rfar412/Part-4-Project-Compendium/README.md

# Part-4-Project-Compendium
Final research compendium to satisfy part 4 project requirements.
