rfar412/Part-4-Project-Compendium/submissions/Sunlink II Light based communication .pptx

## Project #48 Sunlink II: Light-Based Wireless Communication Using Sunlight

Presented by Ryan Farrell and Vivek Chauhan

## Research Question

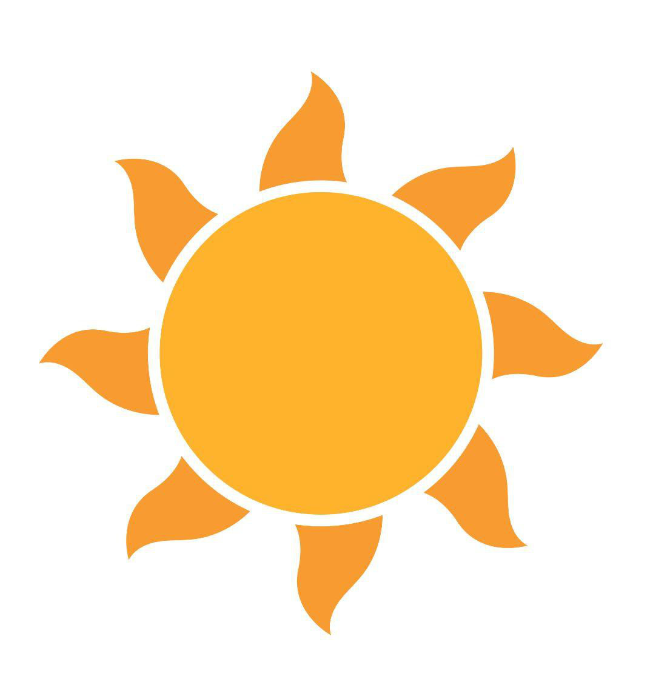
[picture p3: figure]

How can sun-tracking, light based communication systems be designed to provide reliable system-to-system data transmission using direct sunlight, while expanding on existing ambient light-based technologies?

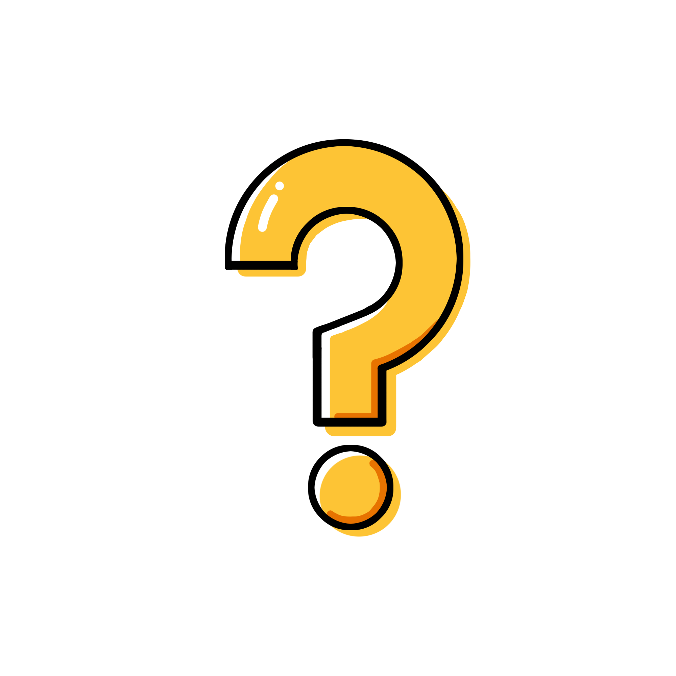
[picture p4: figure]

## Project Introduction

What is Sunlink II ?
- A passive, sunlight-based wireless communication system.
Motivation:
- Avoid RF congestion, enabling low-power, remote sensing data links
- Reliable VLC through Sun tracking and multi-node communication

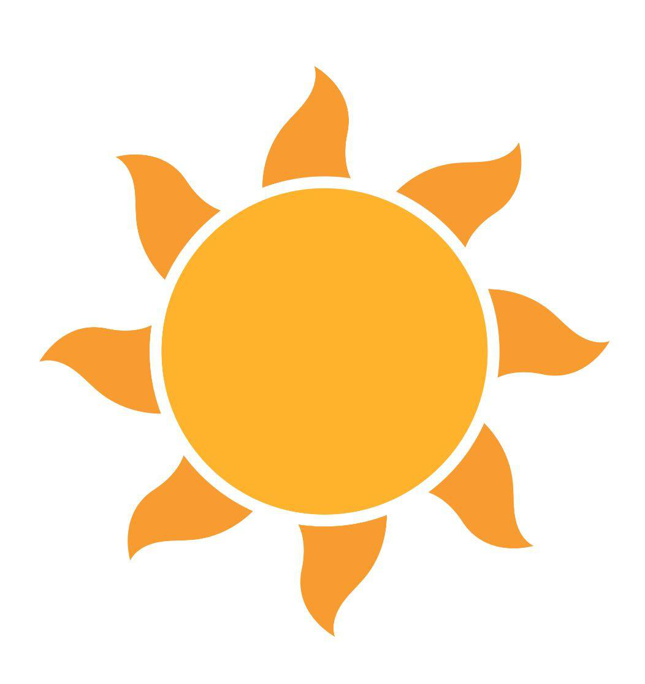
[picture p5: figure]
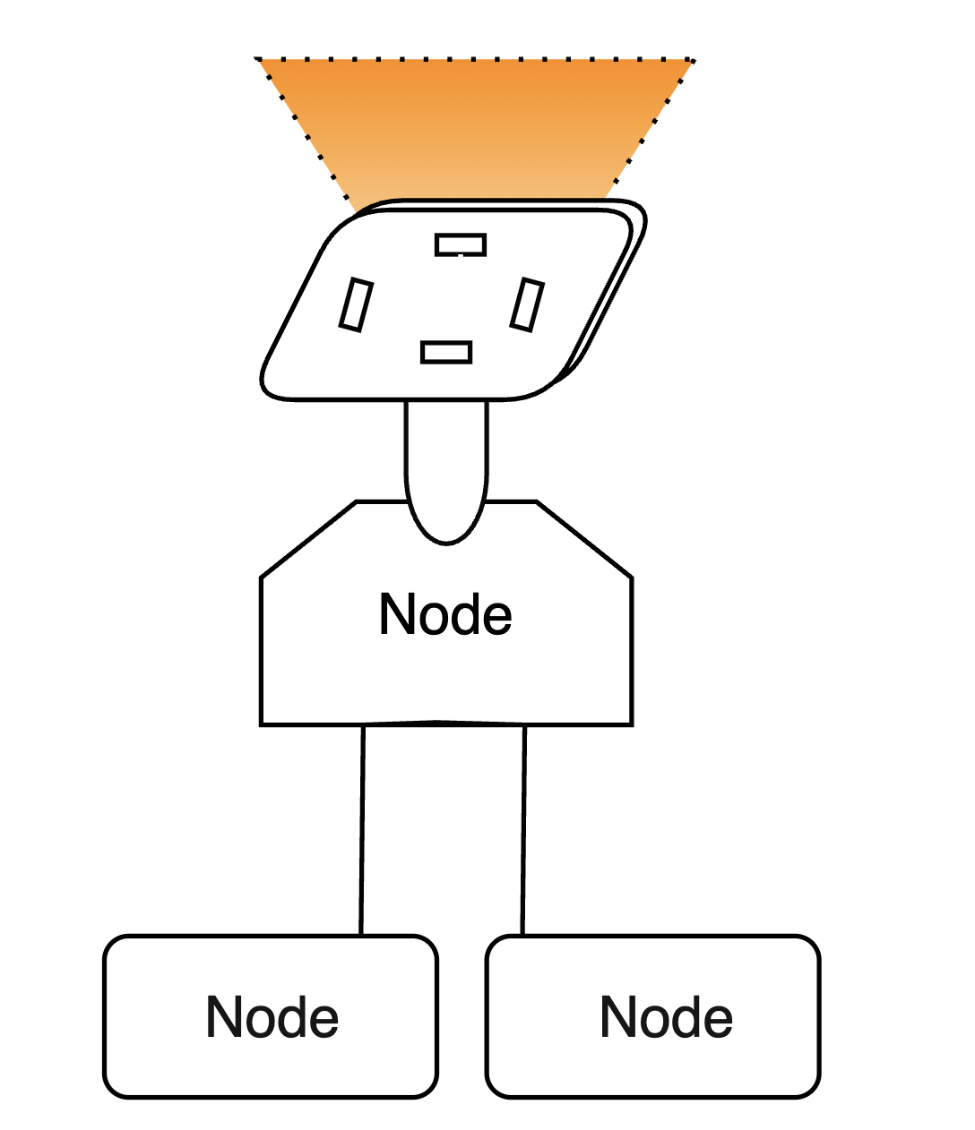
[picture p6: figure]

## System Architecture Overview

Sunlink II

Sun Tracking Subsystem

Multi-Nodal Subsystem

## Sun- Tracking Subsystem

## Sun tracking Problem & Requirements

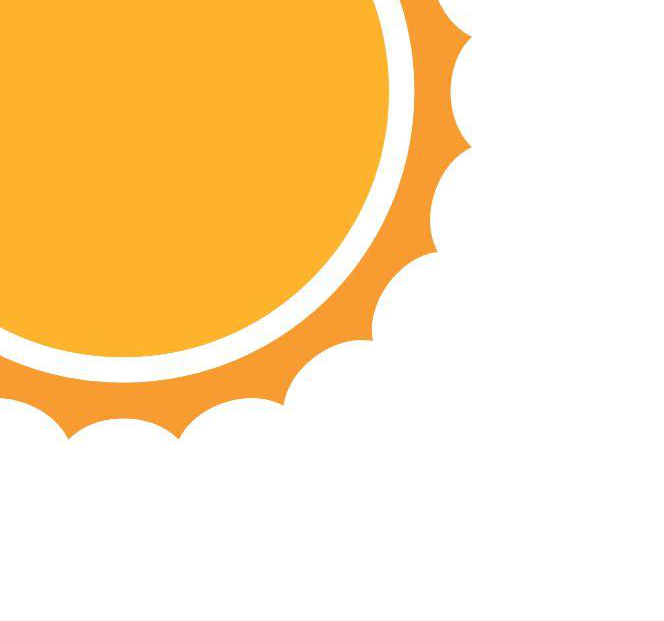
[picture p7: figure]

Why is tracking is needed:
- Sun light azimuth/elevation changes over time.
- Maximising Optical Alignment Improving signal strength
Tracking range required:
- Azimuth: ~180°
- Elevation: ~0-90°

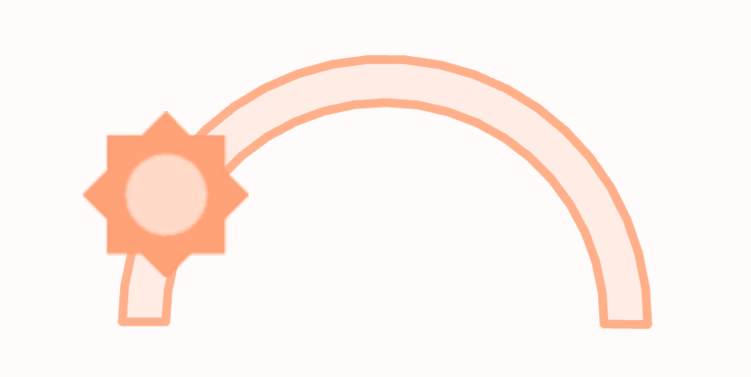
[picture p8: figure]

## Mechanical System Design

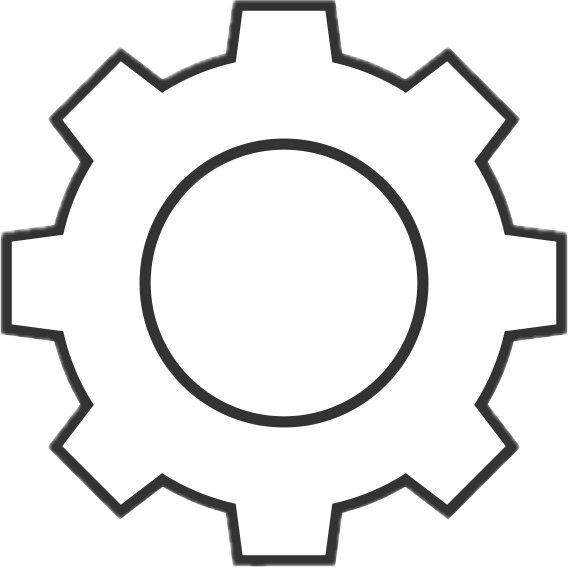
[picture p9: figure]

Dual- axis pan-tilt platform
- Stepper Motor + Driver for Azimuth & Elevation
- Why a Stepper and Servo set-up?
Use of 3D printing for Mock Design, and frame to allow for modular component placement.

## Sensor & Sun Detection

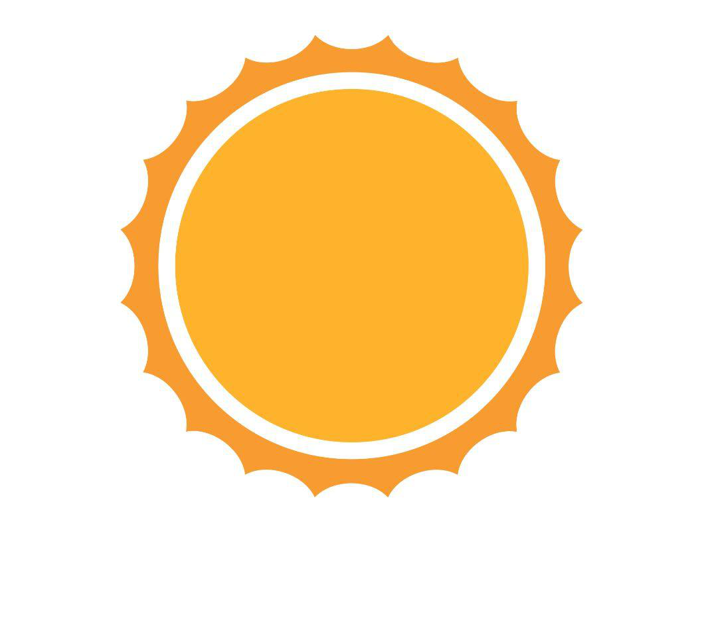
[picture p10: figure]

Sensor Array:
- Hybrid Light Light Dependent Resistor (LDR) + Photodiode Design
Directional Error Logic:
- Quadrant sensor layout for azimuth/ elevation correction
Liquid Crystal (LC) shutter modulator placed along light axis

## Control System Design (PID)

Proportional–Integral–Derivative controller:
Input : Light Imbalance Error

Output : Stepper motor commands ( Step logic )
Microcontroller : MSP-430

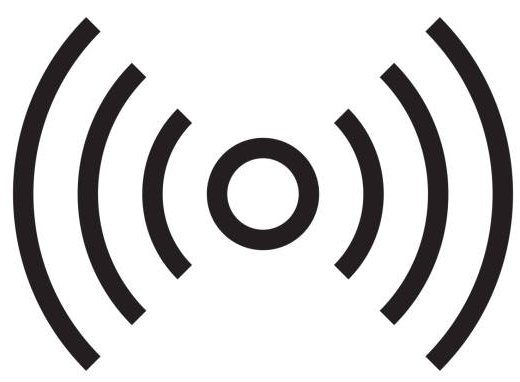
[picture p11: figure]
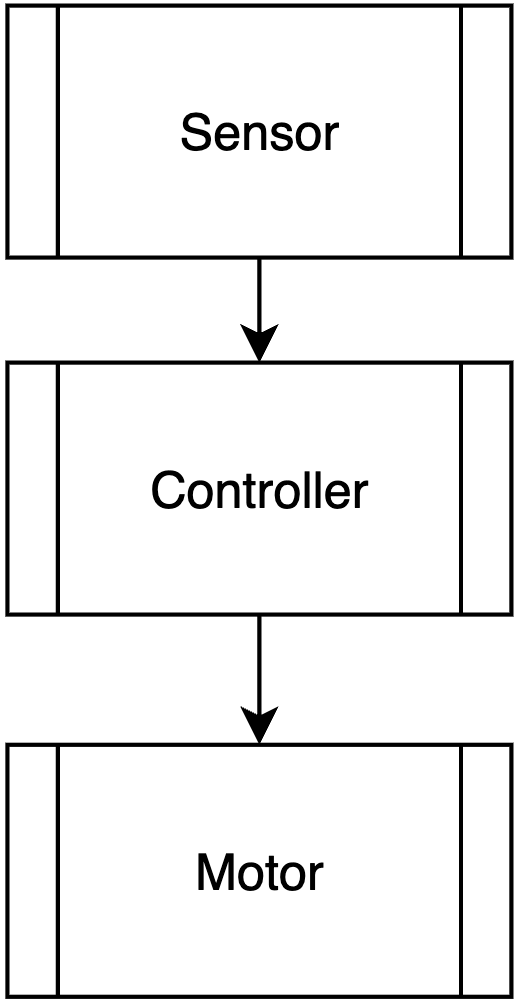
[picture p12: figure]
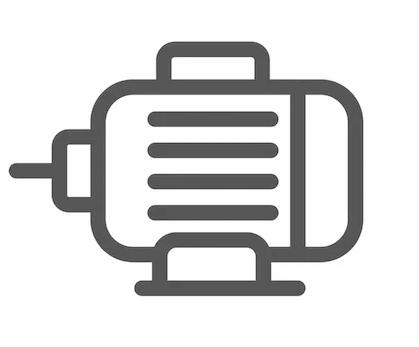
[picture p13: figure]

## Visible Light Communication

## Ambient Light Backscattering

- What is Ambient Light Backscattering (ALB)?
  - The idea of embedding data into existing ambient light
- Why not Radio Frequency (RF)?
  - Passive transmission source -> Low power
  - No powerful transmitter required -> Cheaper
  - RF spectrum -> Clustered

Notes: Talk about low power requirements because no active source (leveraging existing source)

## Ambient Light Backscattering

- How are we utilising this technology?

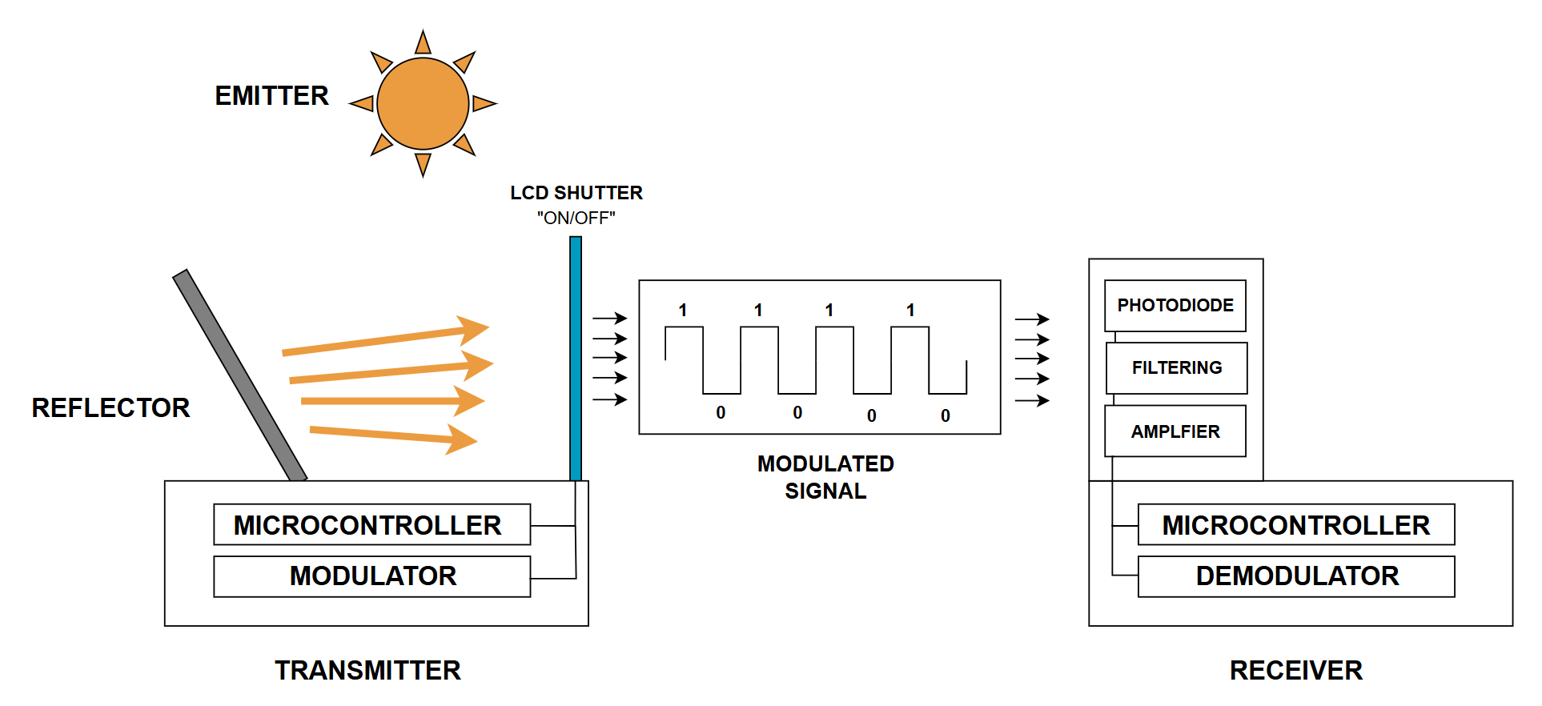
[picture p14: figure]
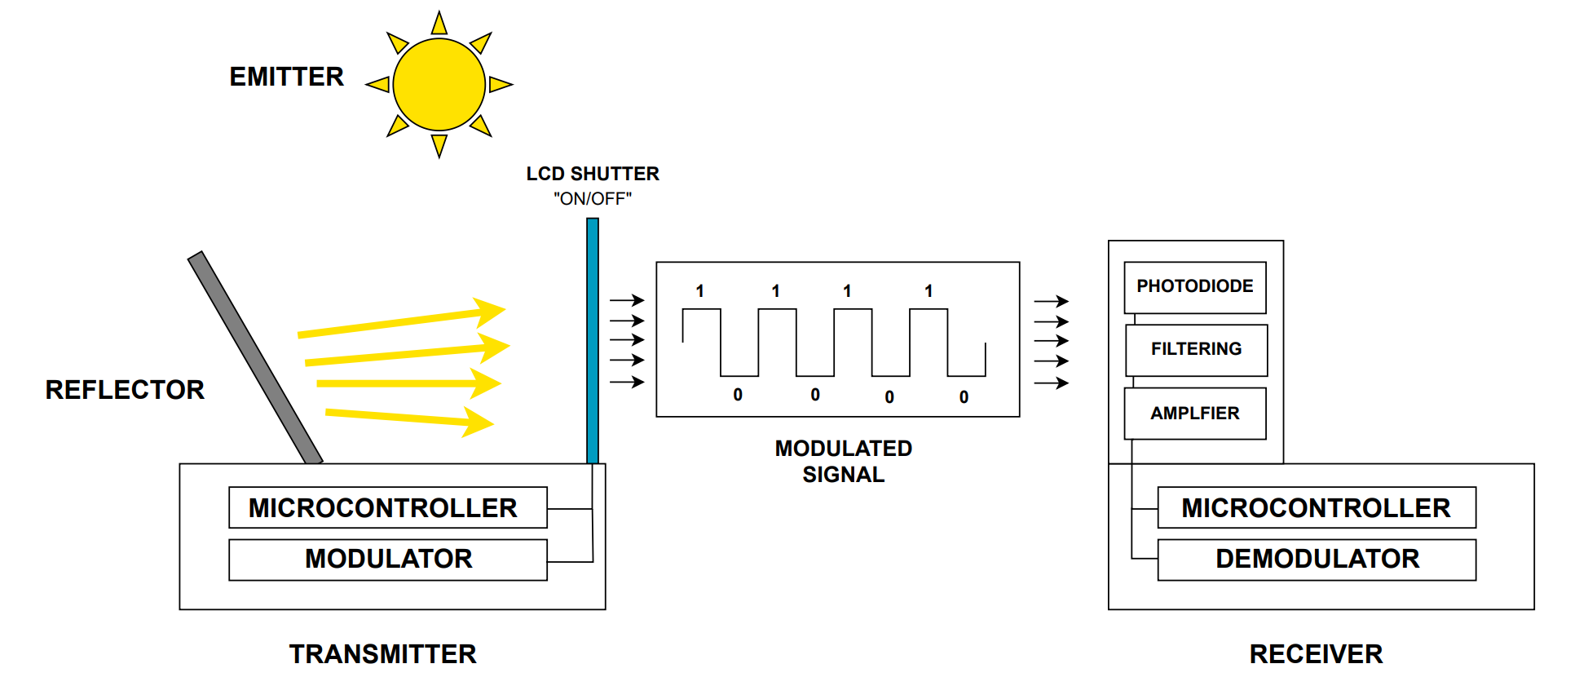
[picture p15: figure]

Notes: Talk about low power requirements because no active source (leveraging existing source)

## User Access and Interface

- Each node has a Bluetooth module for local access
- Users can connect to download the most recent message
- This allows decentralised, resilient access - even if some nodes fail

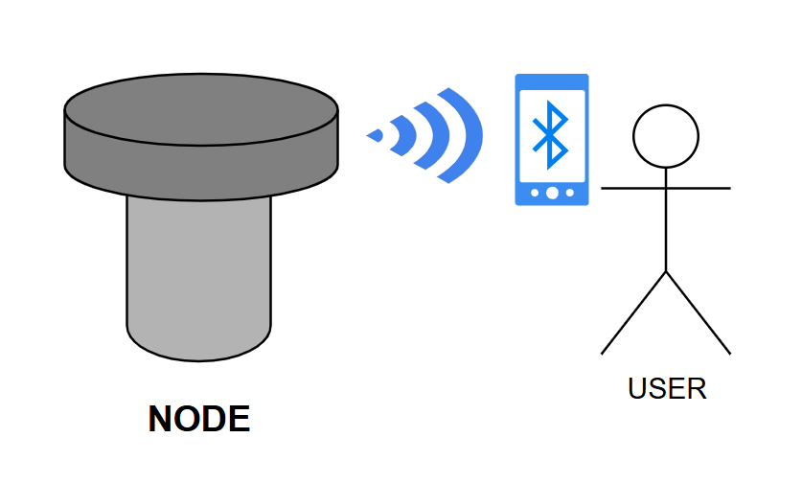
[picture p16: figure]

## Multi-Nodal Communication

- What is a multi-nodal communication system?

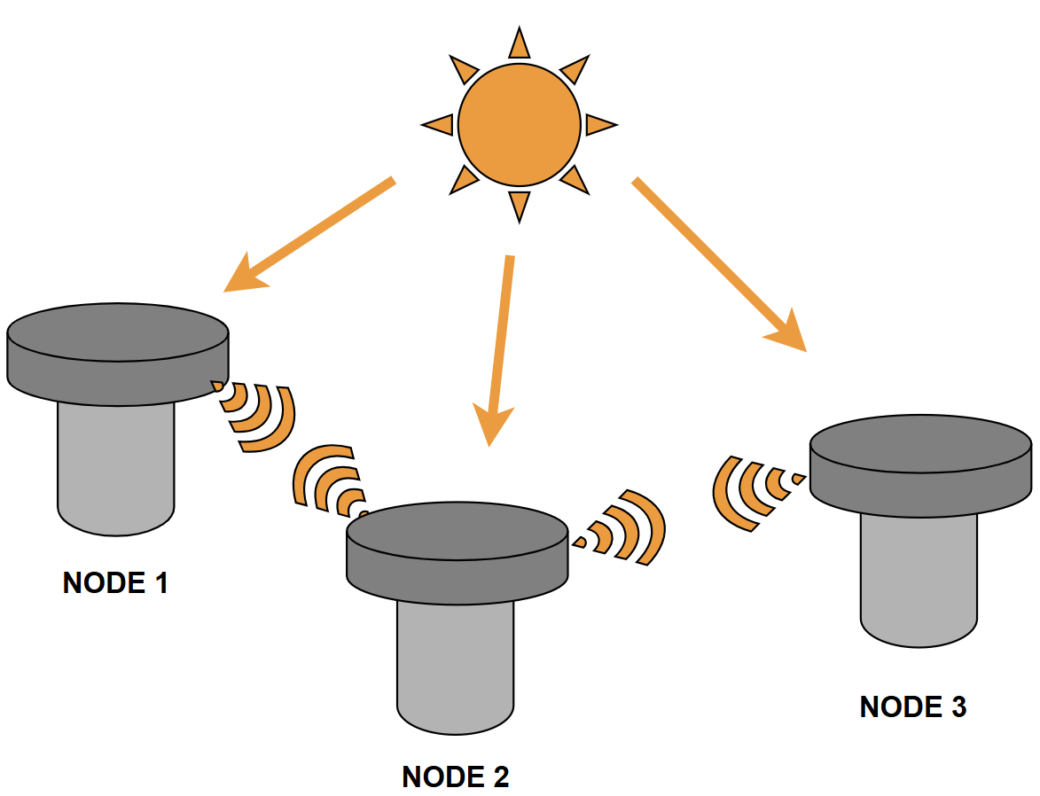
[picture p17: figure]
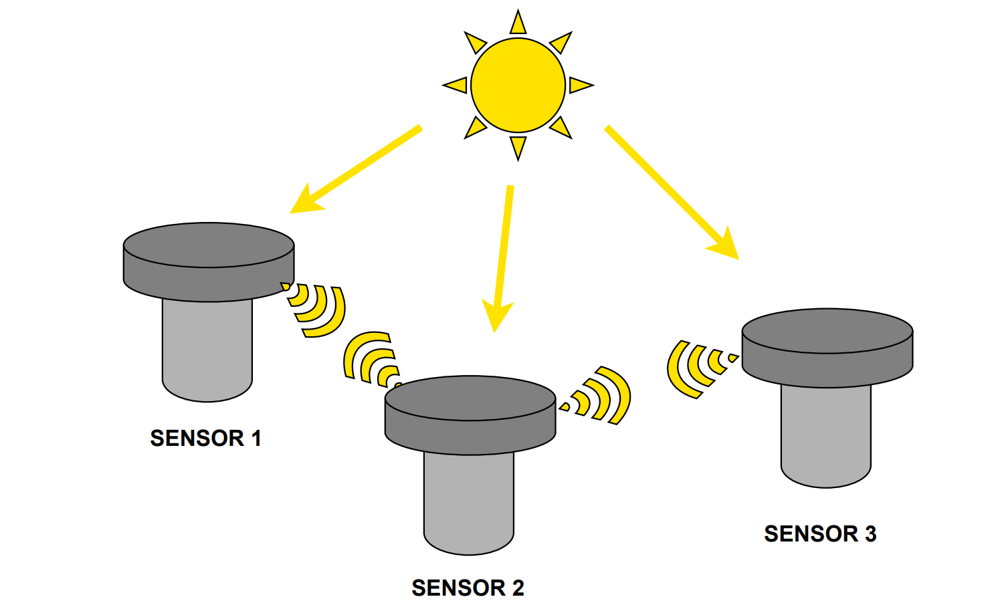
[picture p18: figure]

## Multi-Nodal Communication

- Motivation for multi-nodal system?
- Any similar or existing platforms in research field?

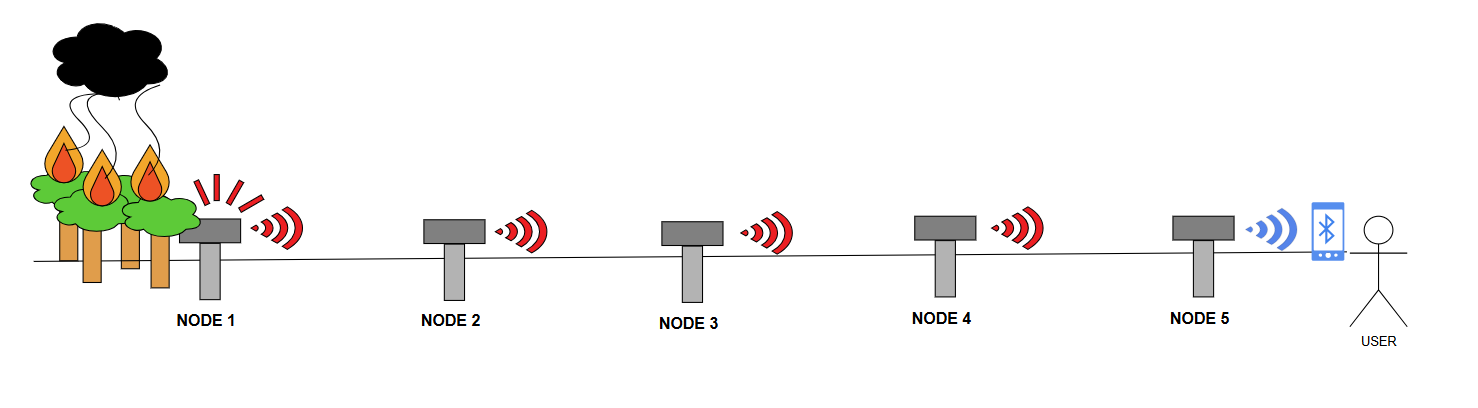
[picture p19: figure]

## Expected Challenges

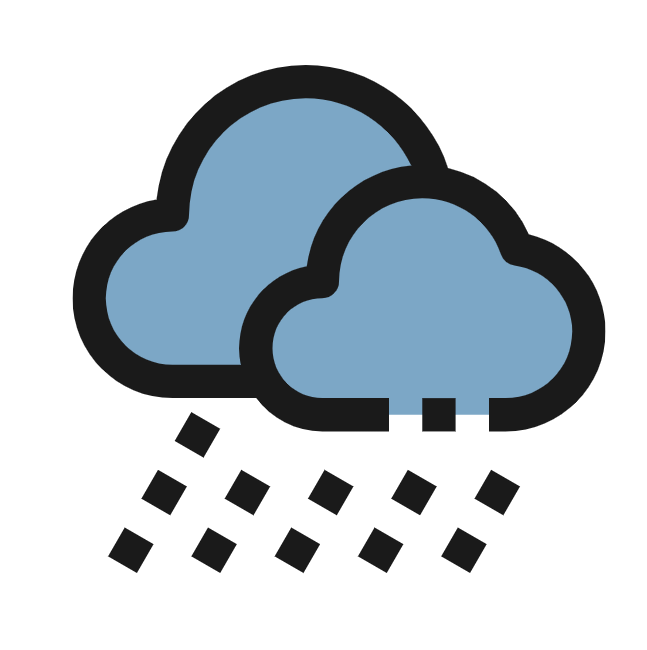
[picture p20: figure]

Challenges
- Sensor alignment for light paths
- Ambient noise
- Weather dependence

## System Integration & Evaluation Strategies

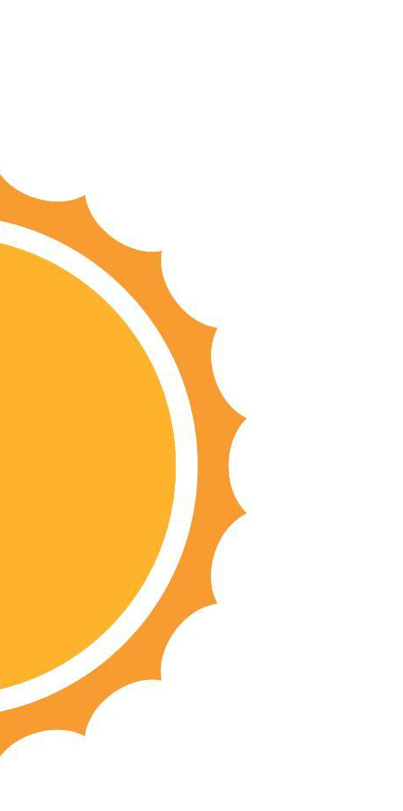
[picture p21: figure]

Sun- Tracking Subsystem | Communication Subsystem
Accuracy | Range
Responsiveness | Message Accuracy
Angular Deviation | Variable Lighting

## System Integration & Evaluation Strategies

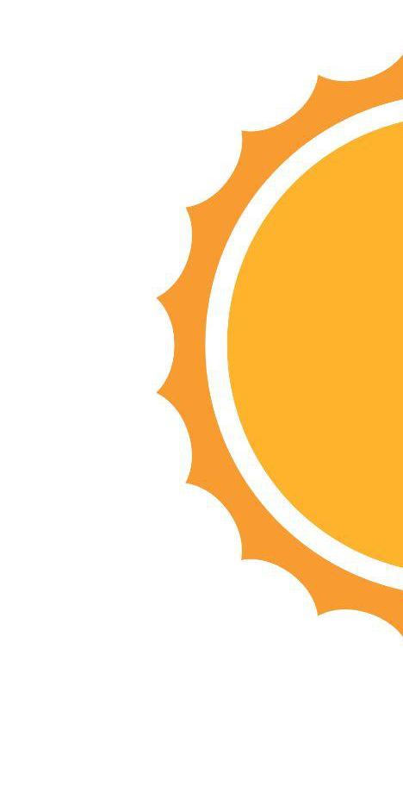
[picture p22: figure]

FULL SYSTEM INTEGRATION
Power consumption
Range
Reliability under different lighting conditions

## Conclusion

Bringing it All Together: A Low-Power, Light-Based Sensing Network

- Low Power - For remote sensing applications
- Sun Tracking - For maximised light signal strength
- Multi-Node - Allows for a signal chain
- Local Access - Decentralised, resilient access

## Thank you for your attention!

- Q&A

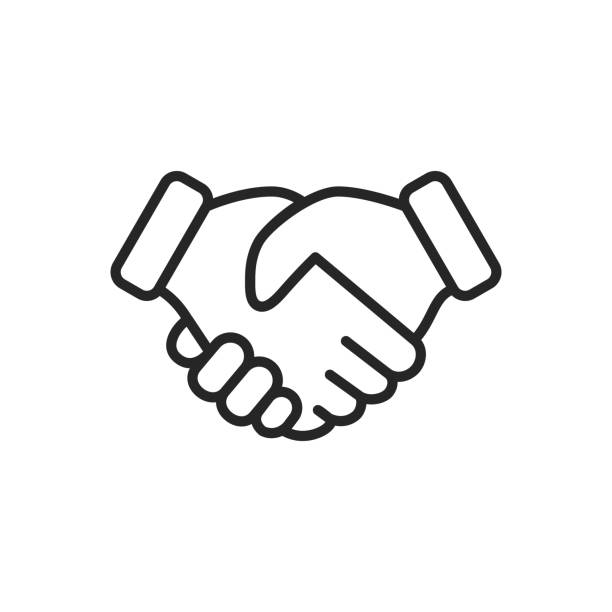
[picture p23: figure]
