rfar412/Part-4-Project-Compendium/project_details/tracking_subsystem_docs/Process Diagram.png

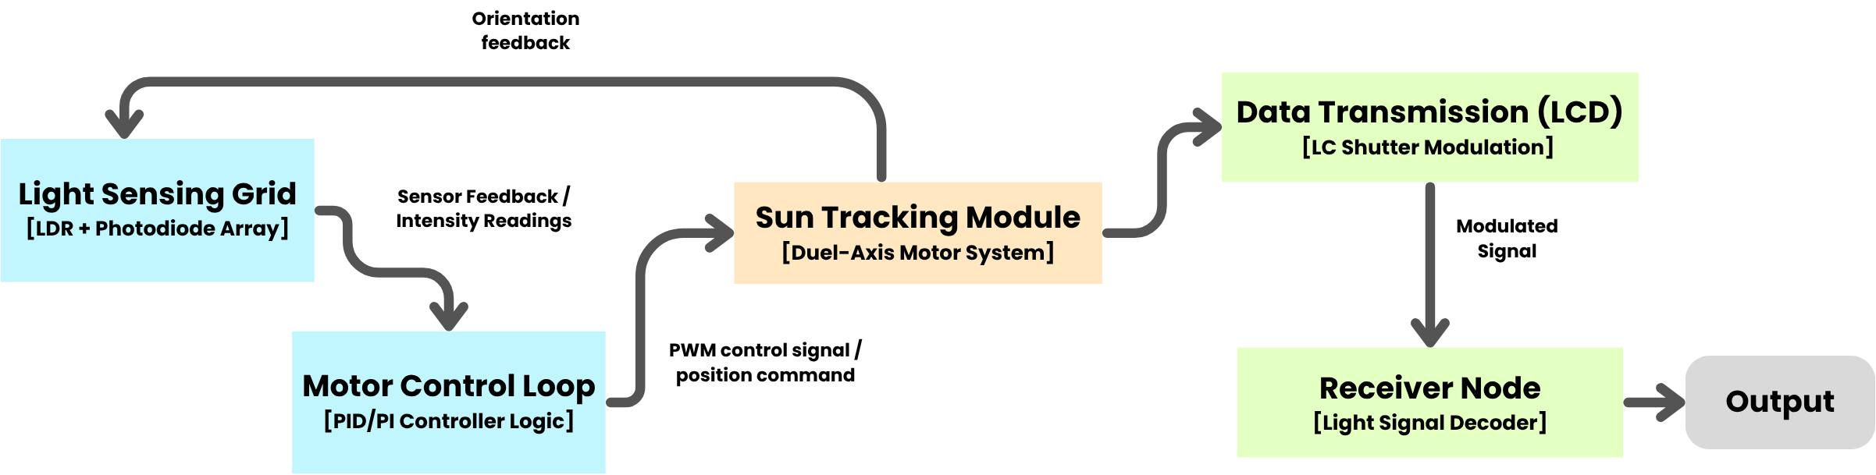
project_details/tracking_subsystem_docs/Process Diagram.png
