rfar412/Part-4-Project-Compendium/project_details/tracking_subsystem_docs/tracking_control_flow.png

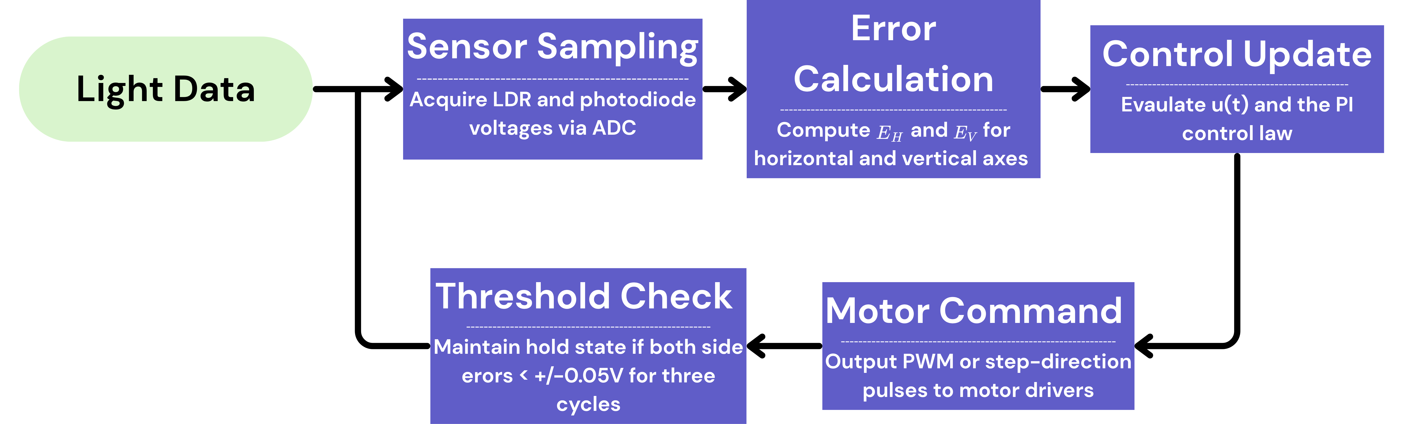
project_details/tracking_subsystem_docs/tracking_control_flow.png
