rfar412/Part-4-Project-Compendium/schematic_parts/communication_subsystem/mosfet_driver.png

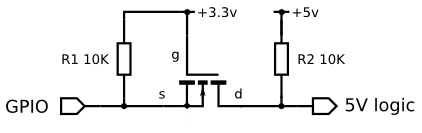
schematic_parts/communication_subsystem/mosfet_driver.png
