rfar412/Part-4-Project-Compendium/schematic_parts/communication_subsystem/receiver_circuitry.png

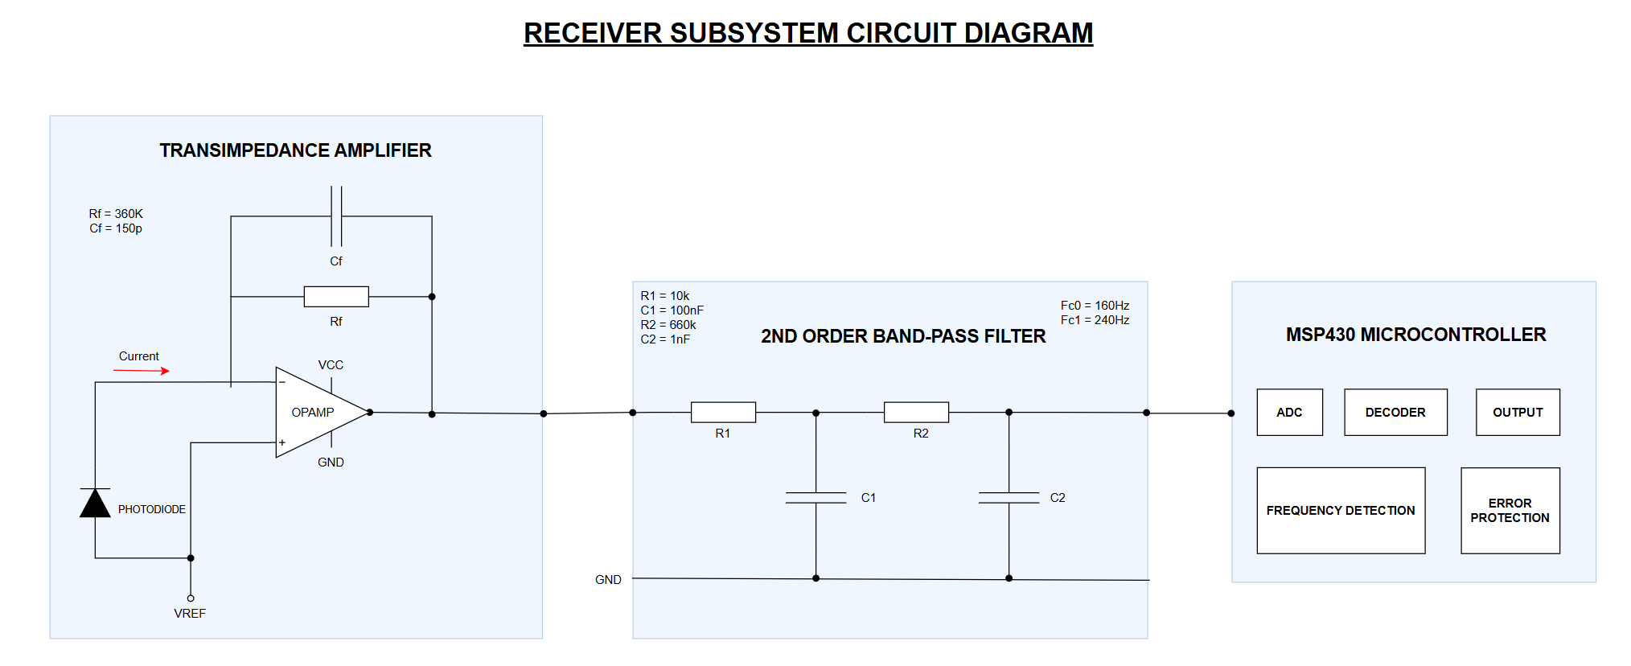
schematic_parts/communication_subsystem/receiver_circuitry.png
