rfar412/Part-4-Project-Compendium/project_details/communication_subsystem_docs/testing_setup.jpg

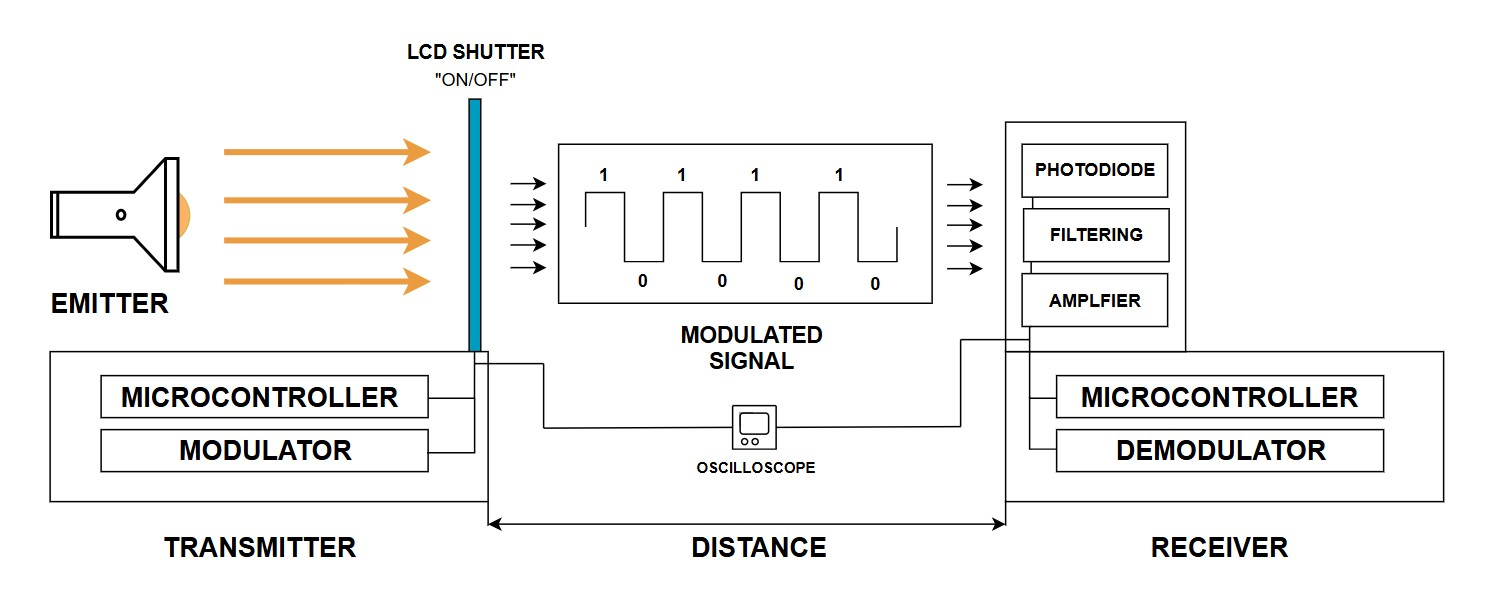
project_details/communication_subsystem_docs/testing_setup.jpg
