rfar412/Part-4-Project-Compendium/results/tracking_subsystem/Motor_Test_Data.xlsx

Parameter | Measured | Simulated
Supply Voltage | 11.76 V | 11.90 V
Coil Voltage Drop | 3.357 V / phase | 3.88 V / phase
Supply Current | 1.325 A | 1.30 A
Motor Back-EMF | 0.789 V | 0.81 V
PWM Switching Frequency | 19.87 kHz | 20.2 kHz
Idle Voltage (no step) | 0.015 V | 0.02 V
Full-Step Voltage (single) | 0.267 V | 0.356 V | Trails | Test One | Test Two | Test Three | Choose Highest Values
Step (0–90°) | 1.265 V | 1.147 V |  | 1.265 V | 1.211 V | 1.235 V
Step (0–180°) | 4.543 V | 4.565 V |  | 4.541 V | 4.5209 V | 4.543 V
Step (0–270°) | 10.087 V | 10.42 V |  | 10.087 V | 10.012 V | 10.036 V
Step (0–90°) | 0.814 A | 0.821 A |  | 0.809 A | 0.799 A | 0.814 A
Step (0–180°) | 0.958 A | 0.965 A |  | 0.951 A | 0.958 A | 0.946 A
Step (0–270°) | 1.224 A | 1.289 A |  | 1.213 A | 1.217 A | 1.289 A
