rfar412/Part-4-Project-Compendium/results/tracking_subsystem/Light Sensor Data.xlsx

Brightness_% | Sensor_Angle_deg | Torch_Angle_deg | Angular_Offset_deg | Aligned_Lux_at_Brightness | Incident_Lux_PD | Incident_Lux_LDR | PD_Voltage_V | LDR_Voltage_V
10 | 0 | 135 | 135 | 200 | 9.56 | 20.03 | 0.4778 | 2.8797
10 | 60 | 135 | 75 | 200 | 58.54 | 69.19 | 2.9269 | 3.8194
10 | 120 | 135 | 15 | 200 | 184.07 | 201.91 | 4.41241 | 4.3628
10 | 180 | 135 | 45 | 200 | 142.16 | 153.79 | 4.05635 | 4.2491
10 | 240 | 135 | 105 | 200 | 10.14 | 20.29 | 1.107 | 2.891
10 | 270 | 135 | 135 | 200 | 9.96 | 20.66 | 0.498 | 2.9063
Brightness_% | Sensor_Angle_deg | Torch_Angle_deg | Angular_Offset_deg | Aligned_Lux_at_Brightness | Incident_Lux_PD | Incident_Lux_LDR | PD_Voltage_V | LDR_Voltage_V
50 | 0 | 135 | 135 | 1000 | 50.52 | 103 | 2.526 | 4.0519
50 | 60 | 135 | 75 | 1000 | 286.1 | 359.45 | 5 | 4.5556
50 | 120 | 135 | 15 | 1000 | 954.52 | 1115.09 | 5 | 4.7885
50 | 180 | 135 | 45 | 1000 | 712.16 | 806.55 | 5 | 4.7375
50 | 240 | 135 | 105 | 1000 | 48.32 | 98 | 2.4159 | 4.0249
50 | 270 | 135 | 135 | 1000 | 48.57 | 100.96 | 2.4284 | 4.0412
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
