rfar412/Part-4-Project-Compendium/project_details/tracking_subsystem_docs/Tracking_sub_testing.png

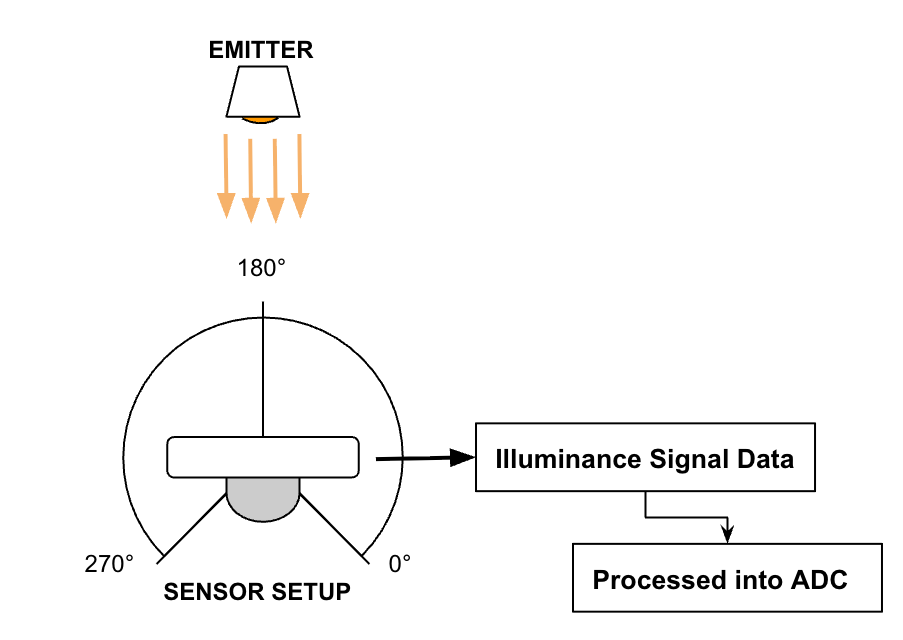
project_details/tracking_subsystem_docs/Tracking_sub_testing.png
