rfar412/Part-4-Project-Compendium/results/communication_subsystem/20cm.png

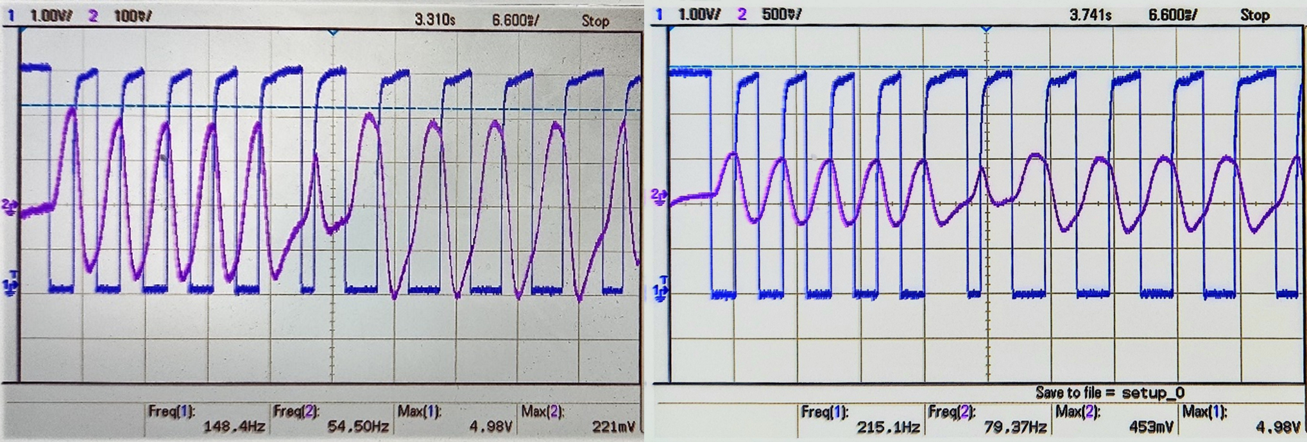
results/communication_subsystem/20cm.png
