rfar412/Part-4-Project-Compendium/results/communication_subsystem/50cm.png

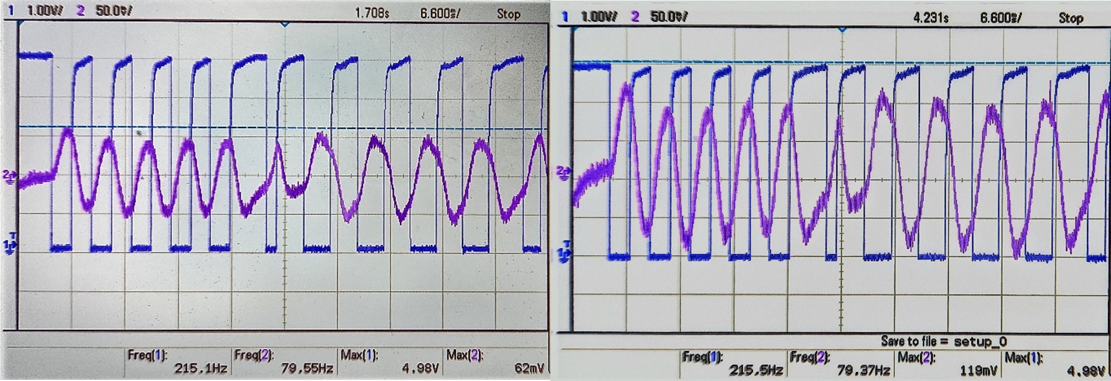
results/communication_subsystem/50cm.png
