rfar412/Part-4-Project-Compendium/results/communication_subsystem/100cm.png

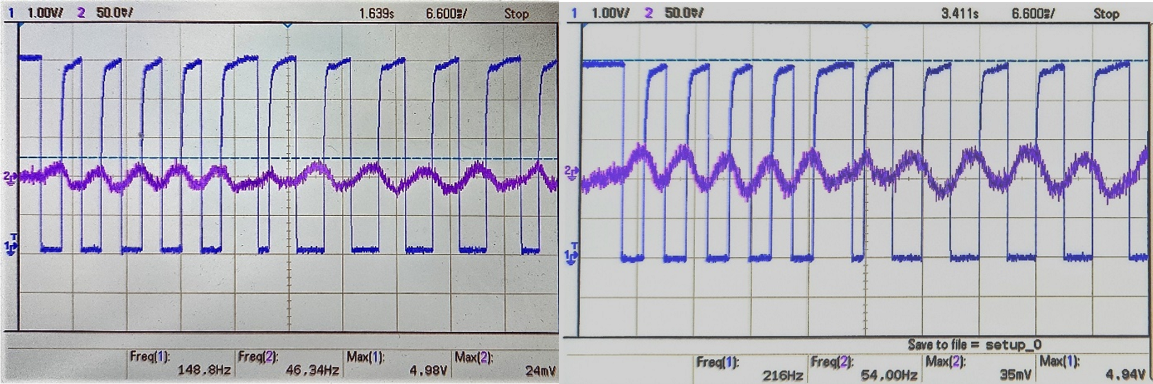
results/communication_subsystem/100cm.png
