rfar412/Part-4-Project-Compendium/results/communication_subsystem/CamScanner 16-10-2025 18.06_5.jpg

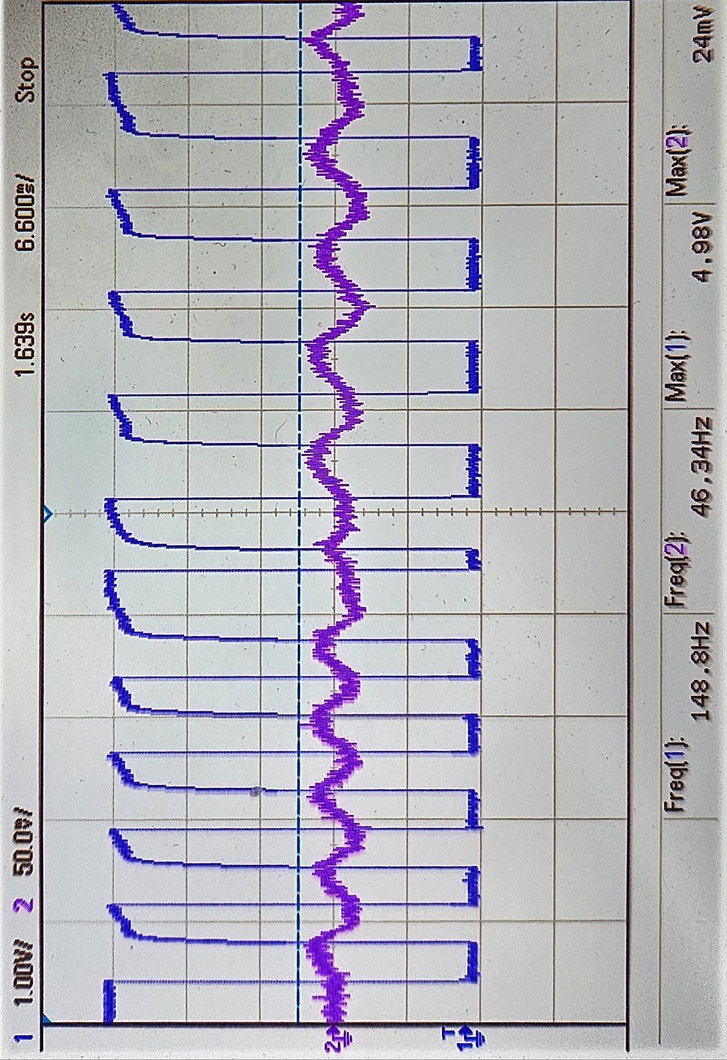
results/communication_subsystem/CamScanner 16-10-2025 18.06_5.jpg
