rfar412/Part-4-Project-Compendium/results/communication_subsystem/graph_communication.png

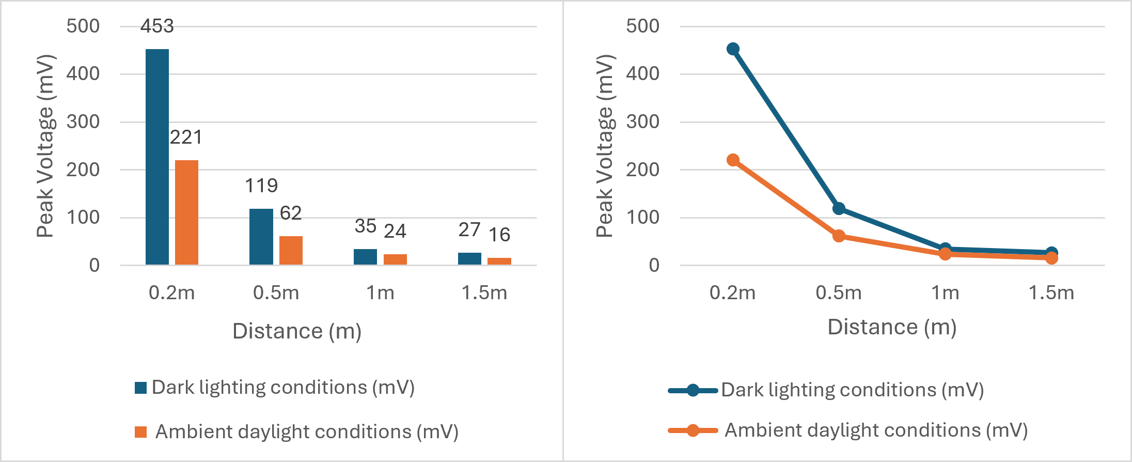
results/communication_subsystem/graph_communication.png
