rfar412/Part-4-Project-Compendium/results/communication_subsystem/noise.png

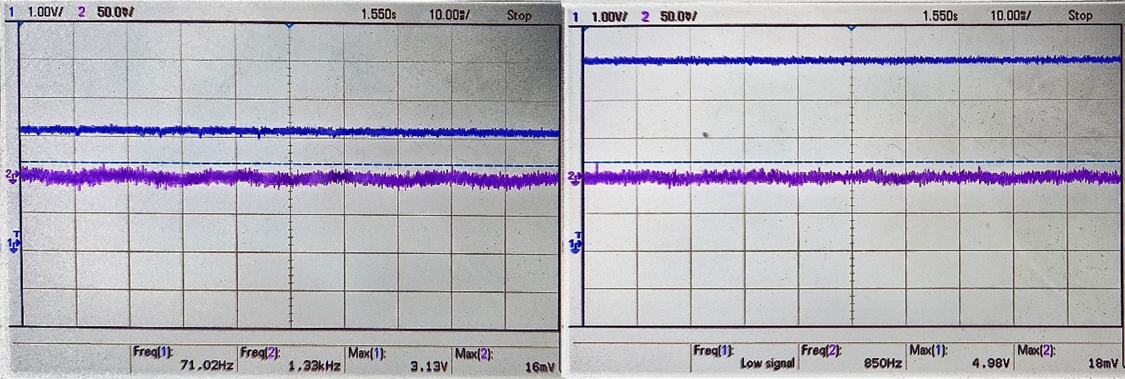
results/communication_subsystem/noise.png
