rfar412/Part-4-Project-Compendium/results/tracking_subsystem/incident_lux_vs_angle.png

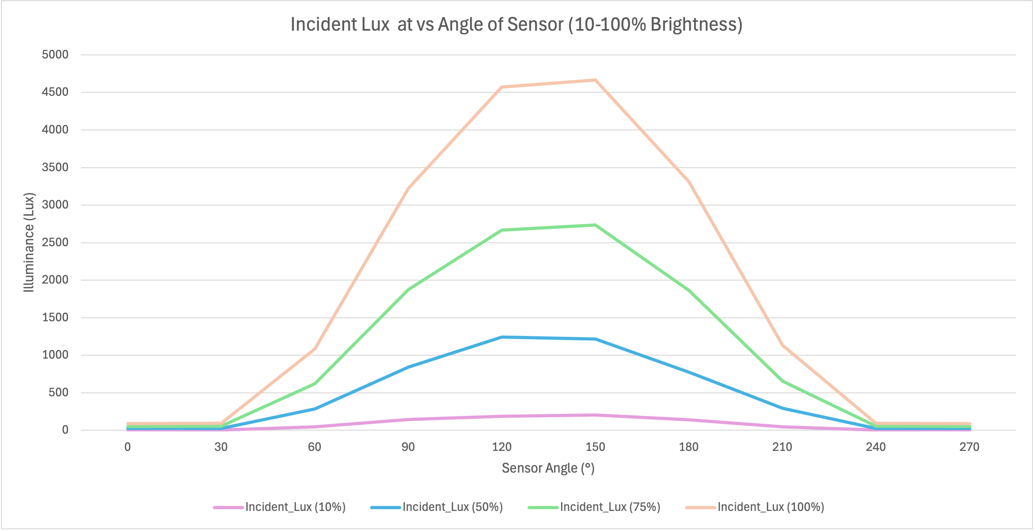
results/tracking_subsystem/incident_lux_vs_angle.png
