rfar412/Part-4-Project-Compendium/results/tracking_subsystem/voltage_vs_angle_10.png

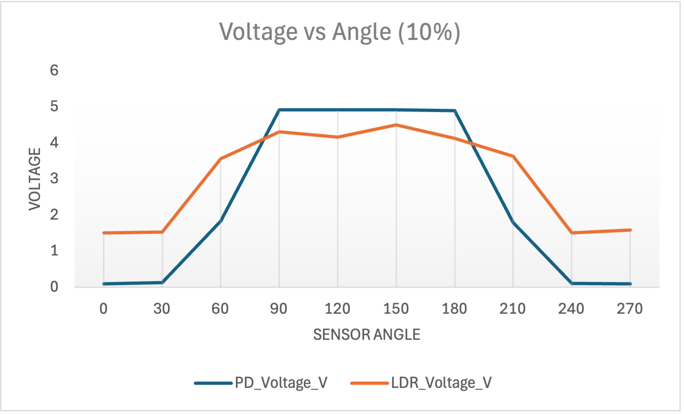
results/tracking_subsystem/voltage_vs_angle_10.png
