rfar412/Part-4-Project-Compendium/results/tracking_subsystem/voltage_vs_angle_50.png

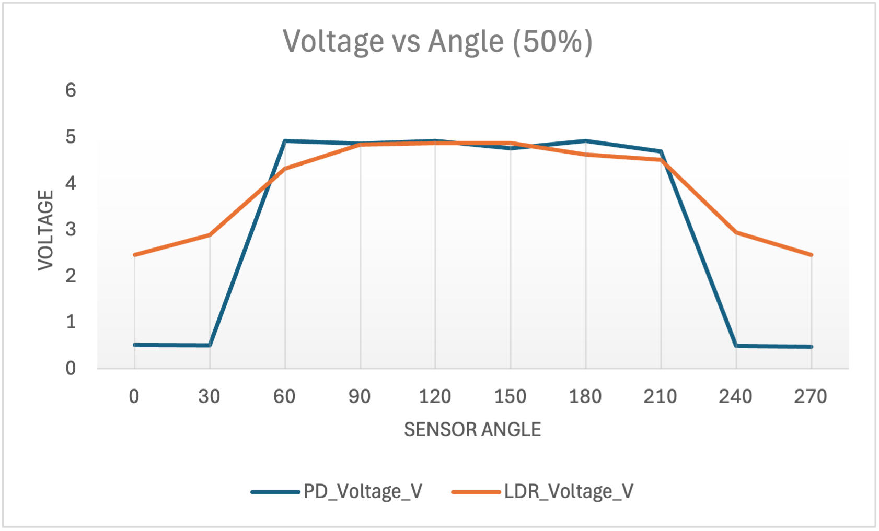
results/tracking_subsystem/voltage_vs_angle_50.png
