rfar412/Part-4-Project-Compendium/results/tracking_subsystem/voltage_vs_angle_100.png

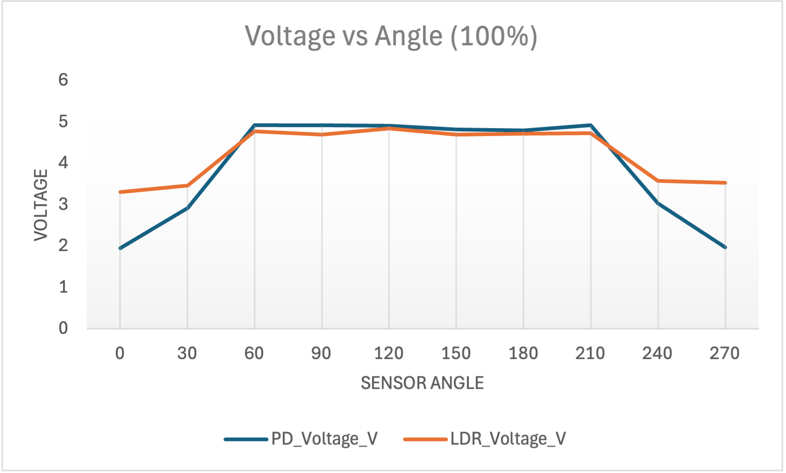
results/tracking_subsystem/voltage_vs_angle_100.png
