rfar412/Part-4-Project-Compendium/schematic_parts/tracking_subsystem/LTSpice/Final_Schematic_simulation.asc

B1: bv; V=v(b30)
B2: bv; V=-(I(B6)*SpeedConversionK1)
B3: bv; V=abs(sin({par}+12*pi/6+v(B10)))
B4: bv; V=(I(B2)*SpeedConversionK1)
B5: bv; V=V(b13)
B6: bv; V=I(Motor_L)
B7: bv; V=I(B27)
B8: bv; V=-(I(B7)*SpeedConversionK2)
B9: bv; V=(I(B8)*SpeedConversionK2)
B10: bi; I=I(B6)
B11: bi; I=I(B6)
B12: bv; V=max(v(b14),max(v(b15),v(b16)))
B13: bv; V=if(V(B12)>{spark2},v(B12),0)
B14: bv; V=abs(sin({par2}+12*pi/6+v(B10)))
B15: bv; V=abs(sin({par2}+12*pi/6+2*pi/3+v(B10)))
B16: bv; V=abs(sin({par2}+12*pi/6+4*pi/3+v(B10)))
B17: bv; V=max(v(b3),max(v(b19),v(b20)))
B18: bv; V=v(b17)*-I(B6)
B19: bv; V=abs(sin({par}+12*pi/6+2*pi/3+v(B10)))
B20: bv; V=abs(sin({par}+12*pi/6+4*pi/3+v(B10)))
B27: bv; V=v(b12)*-I(B7)
B30: bv; V=if(V(B17)>{spark},v(B17),0)
C1: cap; .02
C2: cap; 100p
C3: cap; .02
Inertia1: ind; 10m; Rser=0
Inertia: ind; 10m; Rser=0
Internal_Loss1: res; 1.89m
Internal_Loss: res; 2m
L1: ind; 10µ
Motor_DCR1: res; 7.0
Motor_DCR: res; 7.1
Motor_L1: ind; 100m; Rser=0
Motor_L: ind; 100m; Rser=0
R1: res; 100m
R2: res; 102.3
R3: res; 1
R4: res; 1T
R5: res; 1T
S1: sw
S2: sw
U1: DIAC; SpGap
U2: DIAC; SpGap
V3: voltage; PULSE(0 11.72 1m 10n 1n 4000m 8000m)
Named nets: 0, M1, M2, b10, B17, b30, B3, B19, B20, B12, b13, B14, B15, B16
.tran 0 2 1 10u
Electrical circuit
Internal mechanics
Motor_DCR= Vin/I_stall
Internal_Loss=I_noload/(Vin(1-I_noload/I_stall))
I=current
V=voltage
I=rotation speed
V= torque
Energy exchanged with 
Electrical circuit
Output
.param speedconversionk1=510.898
V= Rotations in RPM
I= torque in 2Pi*Nm
Energy exchanged with
Mechanical circuit
Electrical circuit
Internal mechanics
Motor_DCR= Vin/I_stall
Internal_Loss=I_noload/(Vin(1-I_noload/I_stall))
I=current
V=voltage
I=rotation speed
V= torque
Energy exchanged with 
Electrical circuit
Output
V= Rotations in RPM
I= torque in 2Pi*Nm
Energy exchanged with
Mechanical circuit
.options reltol=0.0001
.model sw sw vt=0.5
.param par 0.1
Start position
Spark parameter
>0.866!
.param spark=0.868
.param speedconversionk2=504.2
.SUBCKT DIAC DIAC_IN DIAC_OUT PARAMS:
+Tr=0.342
+Vbo=13.6V
+Delta_V=19V
+Ibo=15uA
*
*Tr:      Rise time (in µs)
*Vbo:             Break over voltage            
*Delta_V: Dynamic breakover voltage
*Ibo:     Breakover current          
C_C1         N02098 DIAC_OUT 1u IC=0   
V_IDIAC1     DIAC_IN N01041 0 
R_R1         N02098 TRG  {1.462*Tr}  
D_D1         N06161 N01041 DZ19V 
E_ABM1       TRG DIAC_OUT VALUE { IF(ABS(I(V_IDIAC1))>{Ibo},1,0)}    
D_D2         N06161 N01060 DZ19V 
D_D3         N10655 N01060 DZ14V 
D_D4         N10655 DIAC_OUT DZ14V 
S_S1         N01041 N01060 N02098 DIAC_OUT _S1
RS_S1        N02098 DIAC_OUT 1G
C_C2         DIAC_IN DIAC_OUT 10p
****************
* Switch Model *
****************
.MODEL        _S1 VSWITCH Roff=1e7 Ron=2.2 Voff=0.1V Von=0.99V
****************
* Diodes Model *
****************
.model DZ14V    D(Is=3.142f Rs=0.1 Ikf=0 N=1 Xti=3 Eg=1.11 M=.3282
+                               Vj=.75 Fc=.5 Isr=1.973n Nr=2 Bv={Vbo} Ibv=.14467 Nbv=1.093
+                               Ibvl=.1m Nbvl=1.2722 Tbv1=001433.3u)
*
.model DZ19V D(Is=6.994f Rs=5.612 Ikf=0 N=1 Eg=1.11 M=.2906
+                    Vj=.75 Fc=.5 Isr=2.088n Nr=2 Bv={Delta_V} Ibv=.17098 Nbv=1.2072
+                    Ibvl=2.002m Nbvl=1.1457 Tbv1=888.89u)
*               Vz = 18 @ 14mA, Zz = 37 @ 1mA, Zz = 11 @ 5mA, Zz = 7.9 @ 20mA
.ends   
*
*********************************************************************
*                                                               Standard DIACs                                      *
*********************************************************************
*
*$
.subckt SpGap DIAC_IN DIAC_OUT
X1 DIAC_IN DIAC_OUT DIAC params:
+Tr=0.342
+Vbo=20V
+Delta_V=200V
+Ibo=6uA
* 2008 / ST / Rev 1
.ends
*$
Spark parameter
>0.866!
.param spark2=0.868
.param par2 0.1
Start position
